MartinBerdau/AudioRecorder/Display/FFTBack.png

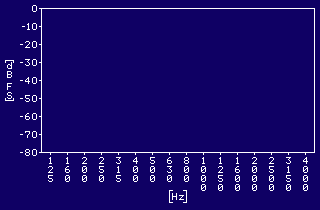
Display/FFTBack.png
