MartinBerdau/AudioRecorder/(threads)

Thread 1 (2020-04-07):

Implementierungen

MartinBerdau, 2020-04-07:
Folgende Funktionen sind geplant:

- [ ] externe Mikrofone anschließen
- [ ] Gain-Regler (über Display)
- [ ] visuelle Angabe der Lautstärke
- [ ] eingebaute Lautsprecher
- [ ] Frequenzanalyse

Thread 2 (2020-04-11):

Quellen

MartinBerdau, 2020-04-11:
Hier sollten alle Quellen gesammelt werden, damit wir einen Überblick haben und nichts vergessen (verwendete Bibliotheken, Code, ...):

- Arduino-Nextion-Library: https://github.com/itead/ITEADLIB_Arduino_Nextion
-

Thread 7 (2020-04-16):

Überlegungen zu Analysetools

MartinBerdau, 2020-04-16:
- [x] FFT
- [x] Terzbankfilterung
- [ ] grafische Darstellung

### **Zu FFT:**

**Funktionen der Audio-Library:**
- 1024 vs 256 point-fft

**Überlegungen:**
- FUNKTION: Falls 256er gut genug aufgelöst ist, diese nehmen, um Rechenleistung für andere Prozesse über zu lassen (Delta_f = 172 Hz).
Falls bessere Auflösung gewünscht, 1024er nehmen (Delta_f = 43 Hz). Diese updated in dem Zyklus in dem auch der Loop arbeitet (83 mal pro Sekunde, also 44100/512).
- FENSTER: Hann-Fenster? Die ganz krassen Fenster gibt es in den Funktionen nicht.

**Beispiel-File:**
- Beispiele -> Audio -> Analysis -> FFT

**Quellen:**
- [1]https://www.pjrc.com/teensy/gui/index.html?info=AudioAnalyzeFFT256
- [2]https://www.pjrc.com/teensy/gui/index.html?info=AudioAnalyzeFFT1024

### **Zu Terzbandanalyse:**

**Überlegungen:**
- FUNKTION: Aus der FFT Bins zusammenfassen, so dass sie ungefähr in ein Terzband passen? (Wird so vorgeschlagen in [1]). Dazu wäre eine 1024er FFT empfehlenswert, damit die Bin-Breite (Delta_f) möglichst klein ist (43 Hz) und nur wenige Terzbänder im tieffrequenten Bereich zusammengefasst werden müssen.
- die individuelle Berechnung von einzelnen Bandpässen wäre wohl zu aufwändig

**Darstellung:**
- auf Nextion mit Progressbars für jedes Terzband?
- Anzahl der Bänder: 26?

**Beispiel-File:**
- siehe [1]

**Quellen:**
- [1]https://github.com/PaulStoffregen/OctoWS2811/blob/master/examples/SpectrumAnalyzer/SpectrumAnalyzer.ino

Closed 2020-05-14.
