MartinBerdau/AudioRecorder/(commit log)

2020-03-29 Ich hab die Readme geaendert
2020-03-29 Aufnehmen mit Nextion mit drei Buttons
2020-03-31 Soll immer im Wechsel aufnehmen und spielen
2020-03-31 Create RecorderNextion.ino
    Aufnahme und Wiedergabe auf SD-Karte gehen, Eingang nur via Line-In
2020-04-02 Update RecorderNextion.ino
    Anpassen der Buttons an die neue GUI
2020-04-11 Pegelmesser in Matlab und C
2020-04-12 Vorbereitung der Implementierung des RMSLevels
2020-04-12 Umbau der Ordnerstruktur. RMSLevel geloescht
2020-04-12 Umbau der Ordnerstruktur. Matlab Code geloescht
2020-04-12 Eigene Bib und Matlab Ordner angelegt
2020-04-12 Einbau des RMS-Messers in Connection Struktur und fs angepasst
2020-04-13 Anpassen des Gain-Reglers und Pegelanzeige (noch nicht richtig skaliert) und der versuch eines Buttons um den Input zu wechseln (klappt noch nicht)
2020-04-16 Hinzufuegen von direct Monitoring und aufnahme stoppen (Am Anfang mehrfach stopp druecken)
2020-04-21 Pegelmeter wird nun anders aufgerufen. Siehe Kommentar im Programm
2020-04-23 Button fuer Aktivierung und Deaktivierung des Pegelmessers hinzugefuegt
2020-05-09 Kleiner Fehler Behoben
    Der von updateRMS() zurückgegebene dB-Wert war ein vergangener Wert und nicht der aktuelle:
    l.47 return 20*log10(m_data[1]); --> return 20*log10(m_data[0]);
2020-05-09 RunningTimeLabel hinzugefuegt und eingebaut
2020-05-14 rms_mono entfernt, sttdessen wird peak1 verwendet
2020-07-13 Erste kommentierung des Hauptprogramms
